biscuitbox/tilt_maze/stl/10_링크블록_x2.stl

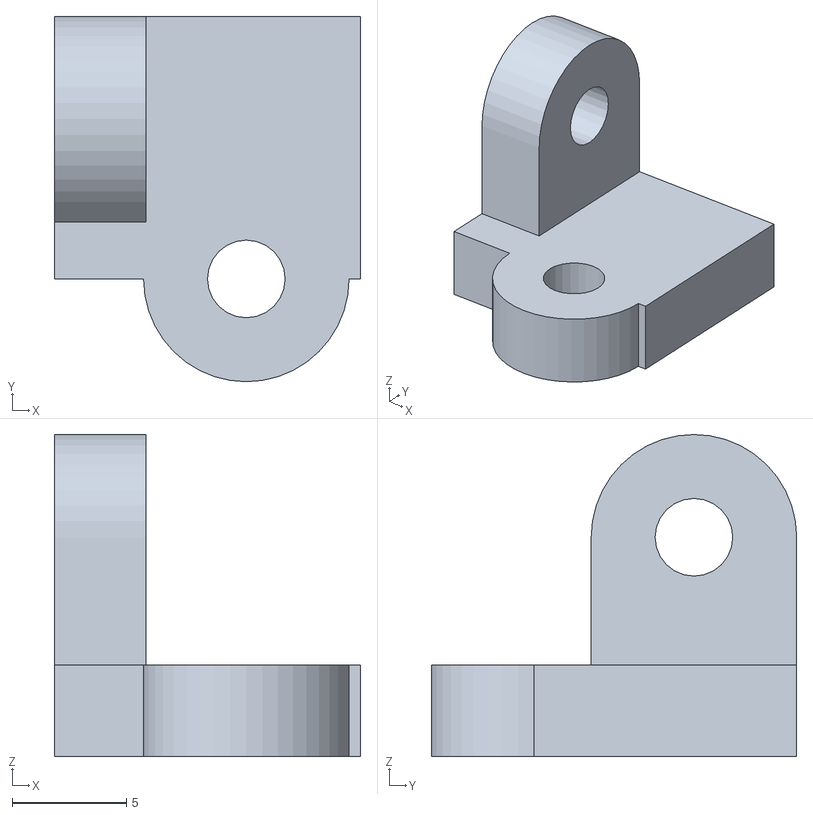
[picture p1: CAD file, 2026-10-22]
stl/10_링크블록_x2.stl
13.4 x 16.0 x 14.1
