biscuitbox/tilt_maze/stl/16a_QR안내판_글자QR(검은색).stl

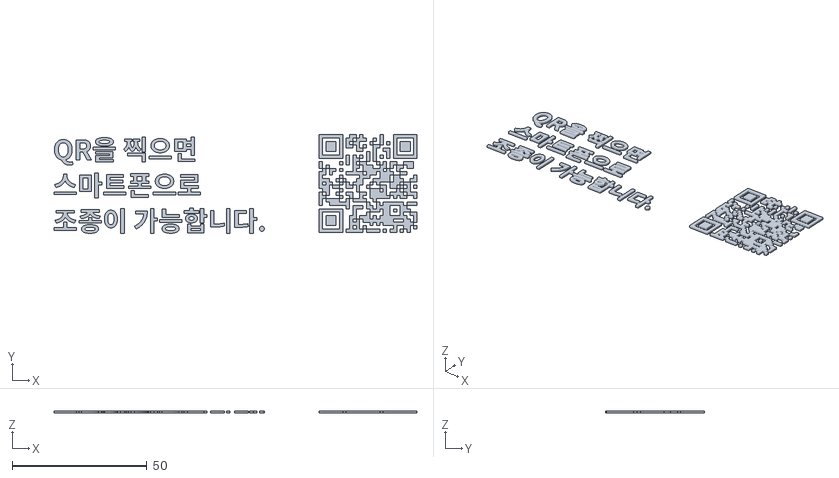
[picture p2: CAD file, 2026-10-22]
stl/16a_QR안내판_글자QR(검은색).stl
134.6 x 36.6 x 0.81
