biscuitbox/tilt_maze/stl/15a_ESP32홀더_38핀.stl

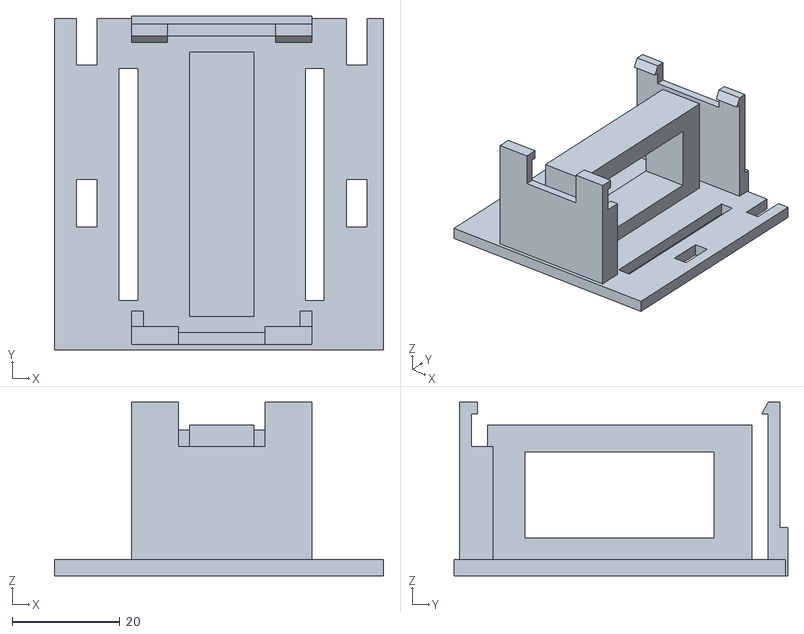
[picture p3: CAD file, 2026-10-22]
stl/15a_ESP32홀더_38핀.stl
61.0 x 61.9 x 32.2
