biscuitbox/tilt_maze/stl/13_배터리_뚜껑.stl

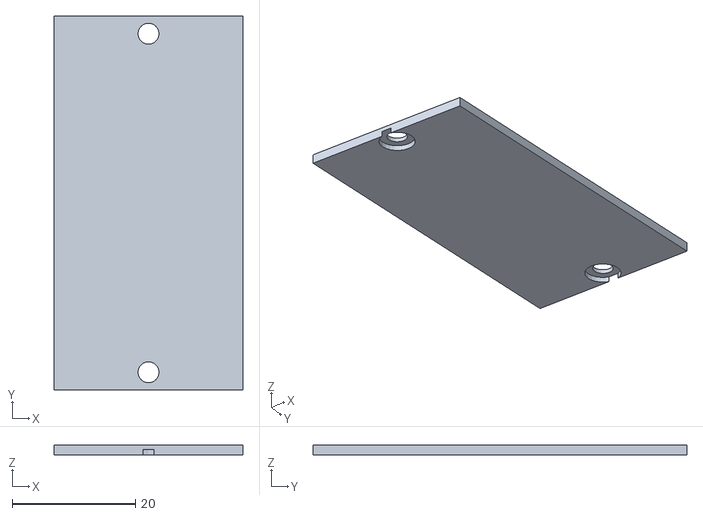
[picture p4: CAD file, 2026-10-22]
stl/13_배터리_뚜껑.stl
30.7 x 60.7 x 1.60
