biscuitbox/tilt_maze/stl/07_조종기_케이스.stl

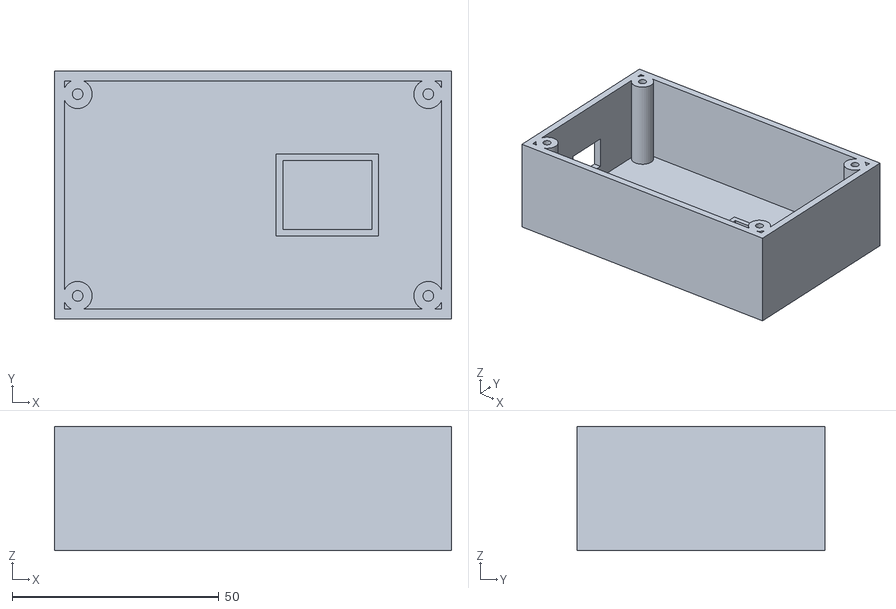
[picture p5: CAD file, 2026-10-22]
stl/07_조종기_케이스.stl
96.0 x 60.0 x 30.0
