biscuitbox/tilt_maze/stl/09a_링크_X_(긴것).stl

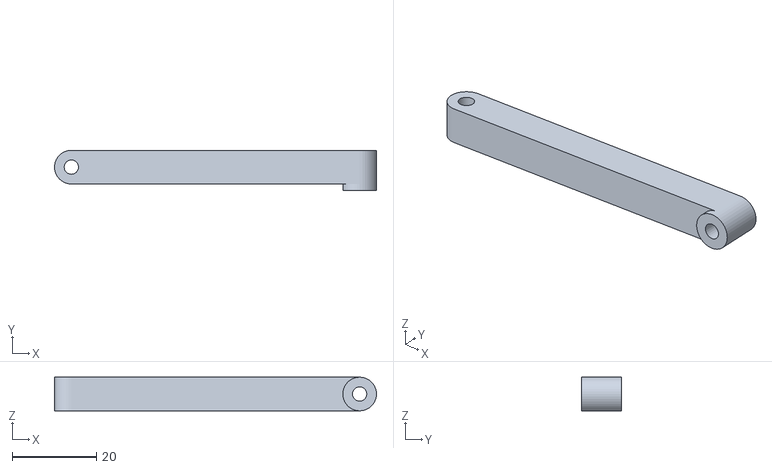
[picture p6: CAD file, 2026-10-22]
stl/09a_링크_X_(긴것).stl
76.5 x 9.60 x 8.00
