biscuitbox/tilt_maze/stl/16b_QR안내판_받침.stl

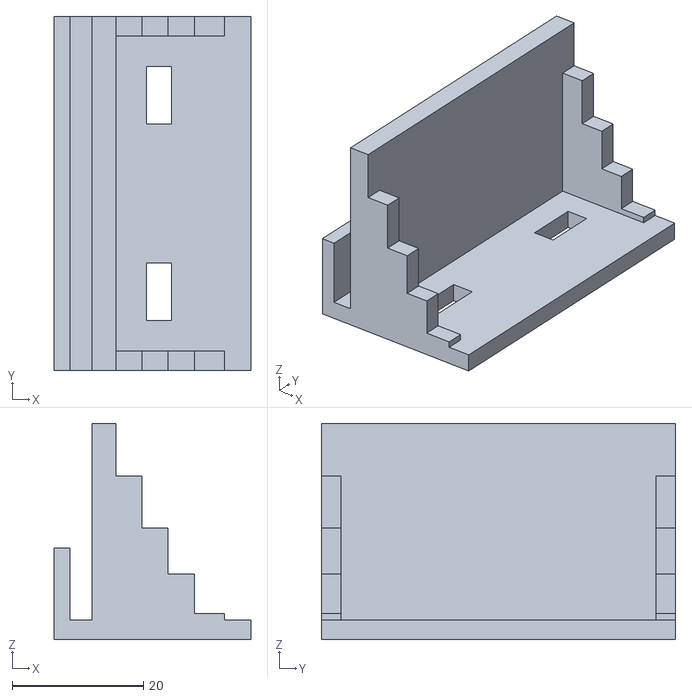
[picture p7: CAD file, 2026-10-22]
stl/16b_QR안내판_받침.stl
30.0 x 54.0 x 33.0
