biscuitbox/tilt_maze/stl/16a_QR안내판_두색.3mf

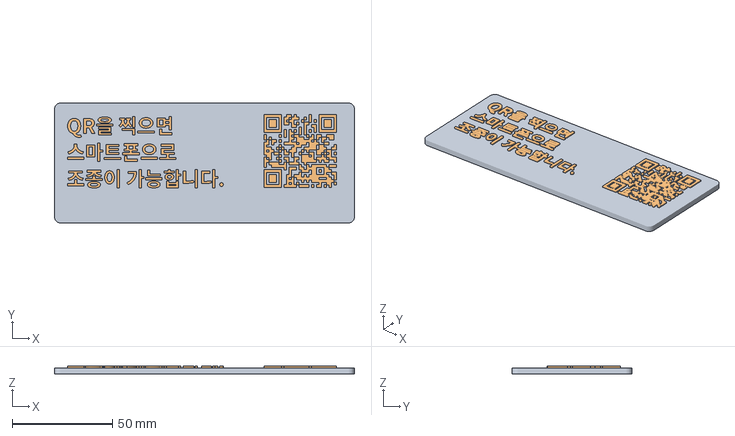
[picture p8: CAD file, 2026-10-22]
stl/16a_QR안내판_두색.3mf
150.0 x 60.0 x 3.80 mm
plate_white
marks_black
