biscuitbox/tilt_maze/stl/15b_ESP32홀더_30핀.stl

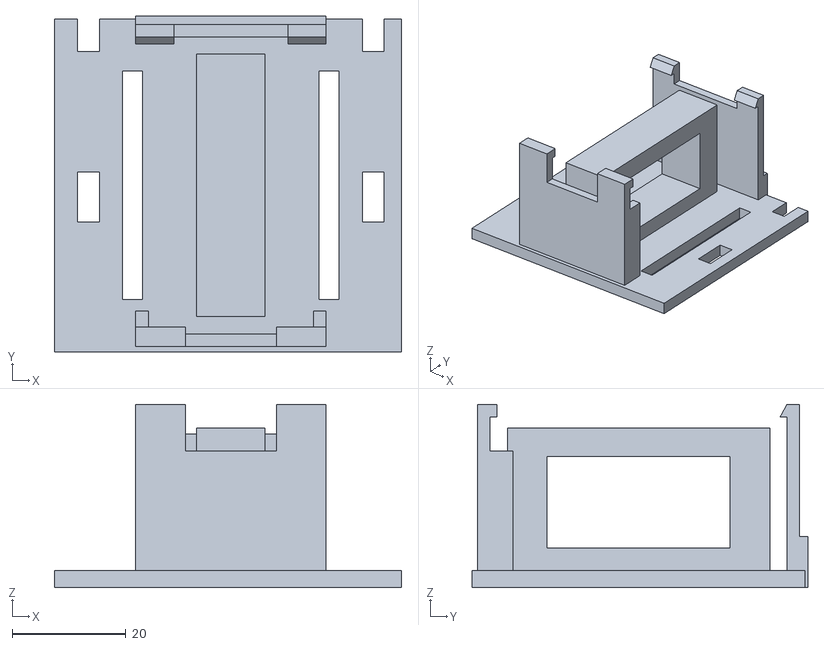
[picture p9: CAD file, 2026-10-22]
stl/15b_ESP32홀더_30핀.stl
61.0 x 59.0 x 32.2
