biscuitbox/tilt_maze/stl/02_하부프레임.stl

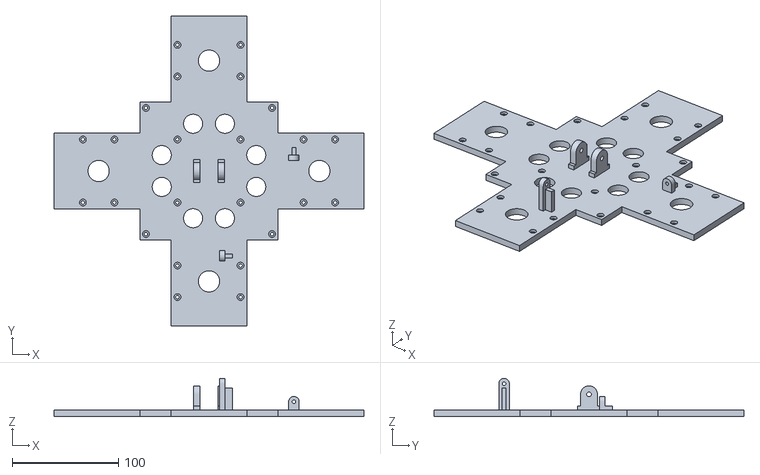
[picture p10: CAD file, 2026-10-22]
stl/02_하부프레임.stl
292.0 x 292.0 x 36.0
