biscuitbox/tilt_maze/stl/04_기둥_아래포크.stl

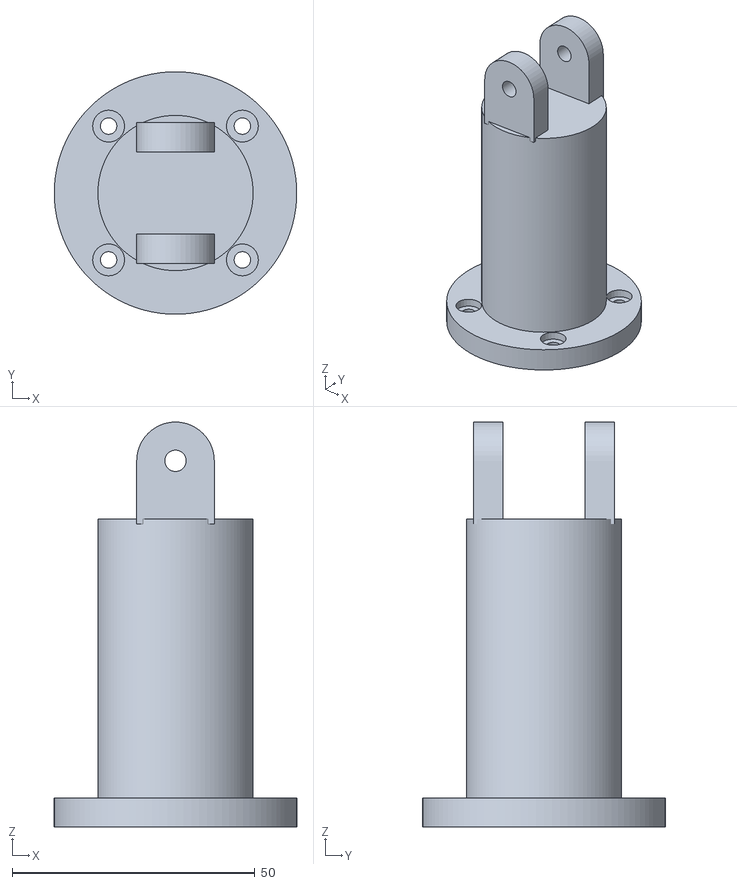
[picture p11: CAD file, 2026-10-22]
stl/04_기둥_아래포크.stl
50.0 x 50.0 x 83.5
