biscuitbox/tilt_maze/stl/01_미로판_300x300.stl

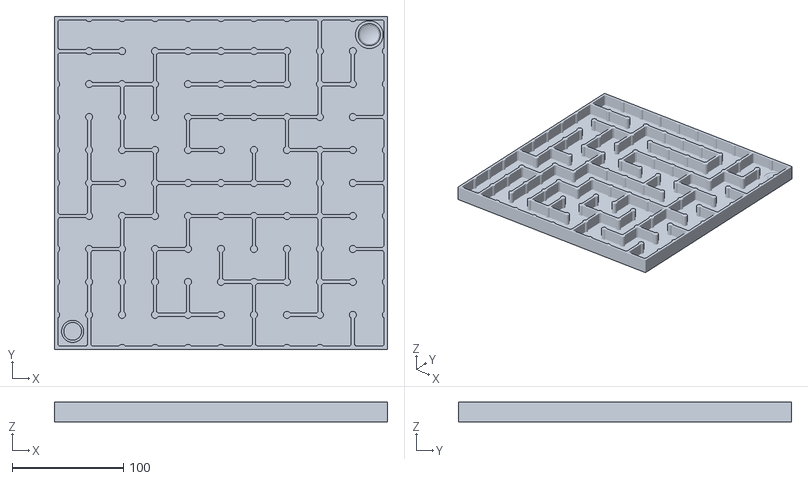
[picture p12: CAD file, 2026-10-22]
stl/01_미로판_300x300.stl
300.0 x 300.0 x 18.0
