biscuitbox/tilt_maze/stl/12_조종기_베젤.stl

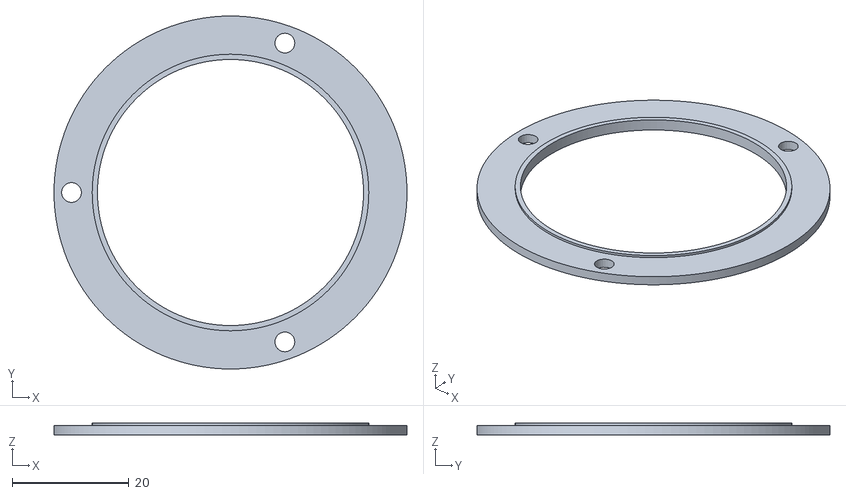
[picture p13: CAD file, 2026-10-22]
stl/12_조종기_베젤.stl
60.5 x 60.5 x 2.00
