biscuitbox/tilt_maze/stl/16a_QR안내판_판(흰색).stl

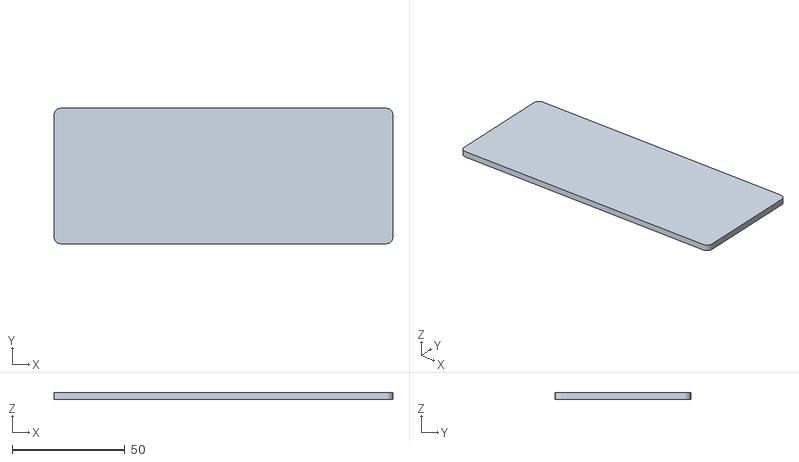
[picture p14: CAD file, 2026-10-22]
stl/16a_QR안내판_판(흰색).stl
150.0 x 60.0 x 3.00
