biscuitbox/tilt_maze/stl/09b_링크_Y_(짧은것).stl

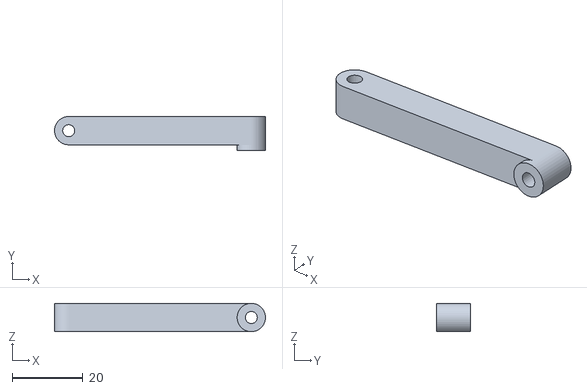
[picture p15: CAD file, 2026-10-22]
stl/09b_링크_Y_(짧은것).stl
59.5 x 9.60 x 8.00
