biscuitbox/tilt_maze/stl/16a_QR안내판.stl

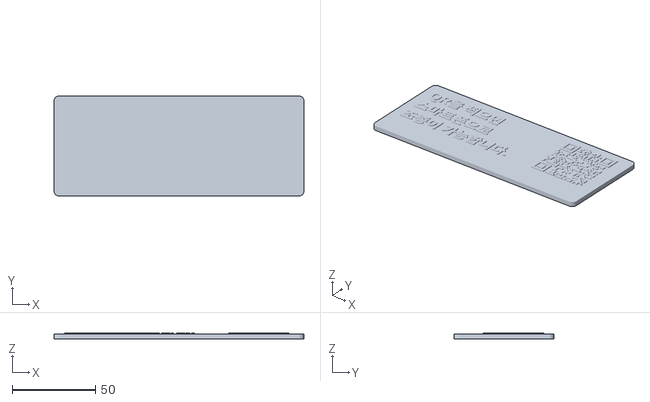
[picture p16: CAD file, 2026-10-22]
stl/16a_QR안내판.stl
150.0 x 60.0 x 3.80
