biscuitbox/tilt_maze/stl/08_조종기_뚜껑.stl

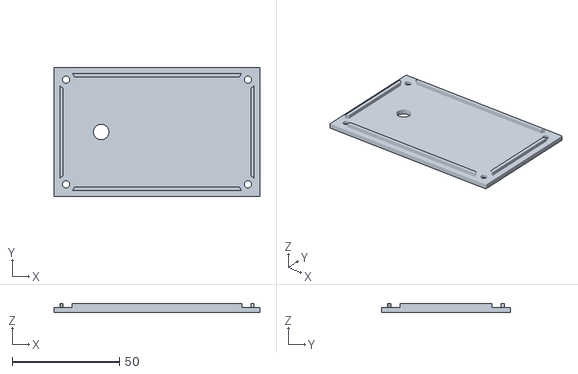
[picture p17: CAD file, 2026-10-22]
stl/08_조종기_뚜껑.stl
96.0 x 60.0 x 4.40
