biscuitbox/tilt_maze/stl/05_서보브래킷_x2.stl

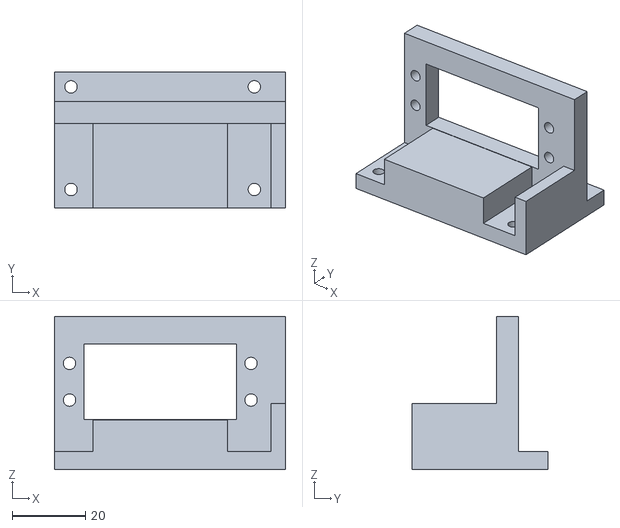
[picture p18: CAD file, 2026-10-22]
stl/05_서보브래킷_x2.stl
63.0 x 37.0 x 41.8
