biscuitbox/tilt_maze/stl/03_십자블록.stl

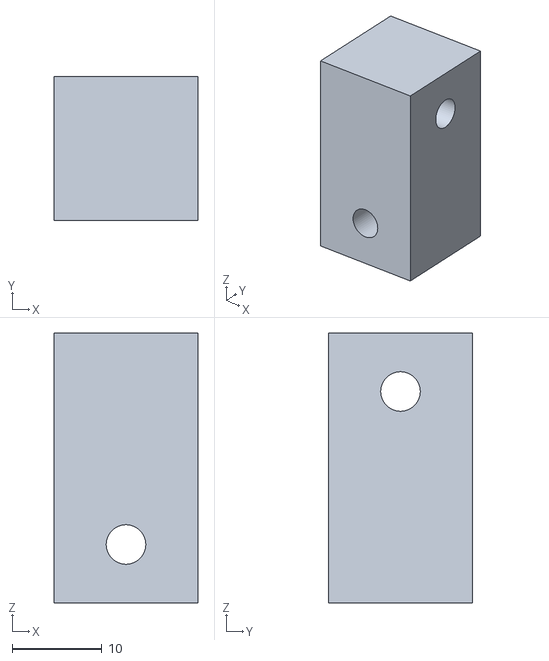
[picture p19: CAD file, 2026-10-22]
stl/03_십자블록.stl
16.0 x 16.0 x 30.0
