biscuitbox/tilt_maze/stl/11_조종기_손잡이.stl

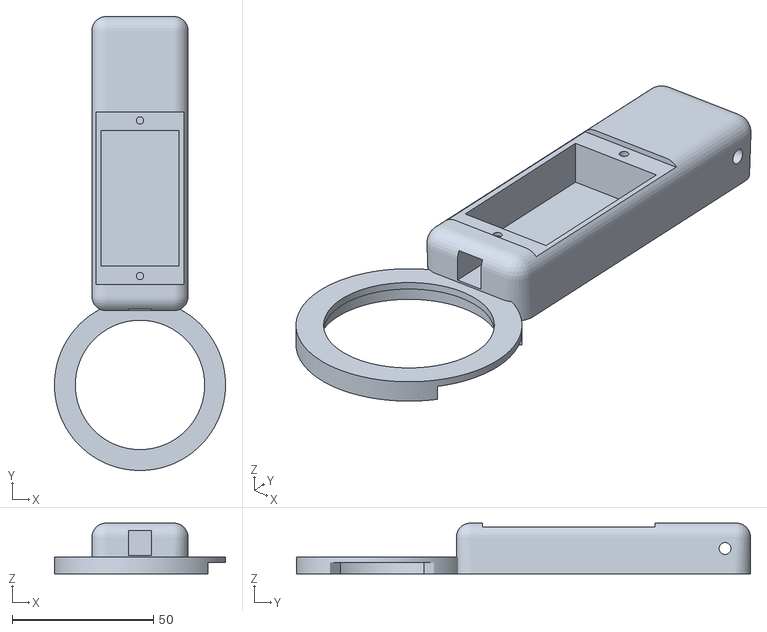
[picture p20: CAD file, 2026-10-22]
stl/11_조종기_손잡이.stl
60.5 x 160.5 x 18.0
