biscuitbox/tilt_maze/stl/14_맞춤확인링.stl

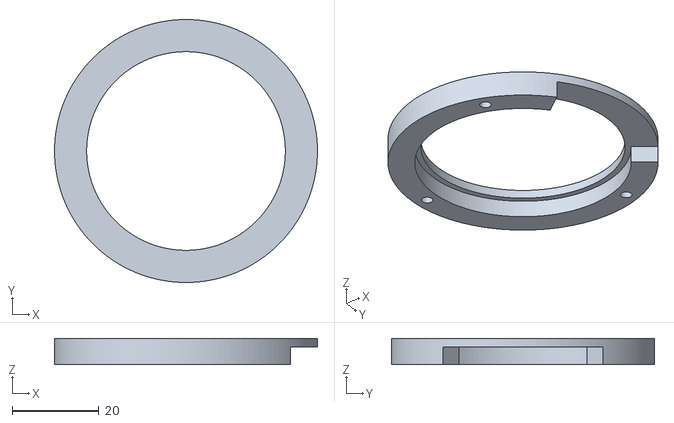
[picture p21: CAD file, 2026-10-22]
stl/14_맞춤확인링.stl
60.5 x 60.5 x 6.00
