biscuitbox/tilt_maze/stl/06_바닥판.stl

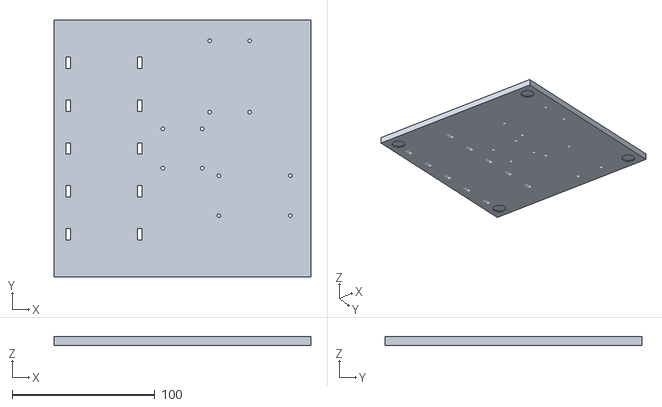
[picture p22: CAD file, 2026-10-22]
stl/06_바닥판.stl
180.0 x 180.0 x 6.00
