biscuitbox/tilt_maze/guide/index.html

ESP32 × 2 · MPU6050 · MG996R × 2 · ESP-NOW

# 원격 기울기 미로

손에 든 조종기를 기울이면, 떨어져 있는 300 mm 미로판이 같은 방향으로 기울어집니다. 구슬을 출발점에서 도착 홈까지 굴려 보내세요.

미로판 300 × 300 mm 칸 10 × 10 (간격 29.7 mm) 최단 경로 79칸 최대 기울기 ±8° 프린터 뱀부랩 H2S

## 내려받기

출력 파일 · 아두이노 코드 · 설계 원본

⬇ 전체 파일 한 번에 (zip) STL 출력 파일 (https://github.com/biscuitbox/tilt_maze/tree/main/stl) 아두이노 코드 (https://github.com/biscuitbox/tilt_maze/tree/main/code) 설계 원본 (Python) (https://github.com/biscuitbox/tilt_maze/tree/main/cad) 📱 스마트폰 조종 페이지

zip 안에 stl(출력 파일), code(미로·조종기 아두이노 코드), cad(치수를 바꿔 다시 만들 수 있는 파이썬 설계 원본)가 들어 있습니다. 아래 시뮬레이터로 먼저 움직임을 확인한 뒤 출력 목록과 조립 순서를 따라 만드세요.

## 시뮬레이터

구슬을 출발 고리에서 도착 홈까지

3D 모델 불러오는 중…

00:00.0

도착! 00:00.0

이니셜

기록 저장저장 안 함

미로판 정렬 처음부터 난이도 민감도 끝내기

드래그

처음부터 자동 시연 미로판 정렬 전체 화면

📱 이 폰 기울기로 조종 📱 폰을 조종기로 조종기 연결 (USB)

입력: 키보드·드래그

코드 ·····

준비 중…

폰 카메라로 QR을 찍어 열고 시작하기를 누르세요. 폰을 편하게 든 채로 미로판 정렬을 누르면 그 자세가 수평이 되고, 컴퓨터 화면이 기준 시점으로 돌아갑니다.

방향키·W·A·S·D·드래그·폰 모두 지금 보이는 화면 기준으로 움직입니다(위 = 화면 안쪽). 마우스로 화면을 끌면 시점이 돌아가고, 미로판 정렬을 누르면 출발점이 왼쪽 위에 오는 기준 시점으로 돌아옵니다. USB 조종기 연결은 내려받은 파일(tilt_maze_sim.html)을 크롬·엣지에서 열었을 때 동작합니다.

정답 경로 보기 조종기 표시 미로판만 보기

### 기록판

이 난이도 기록 지우기

도착하면 이니셜(3글자까지)로 기록을 남길 수 있습니다. 난이도마다 빠른 순서로 10개까지 보입니다. 검은 구멍에 빠지면 출발점에서 다시 시작하고 시간은 계속 흐릅니다. 자동 시연이나 정답 경로를 켠 판은 기록하지 않습니다.

미로판 하부프레임 기둥·십자블록 서보 브래킷 링크 링크블록 조종기

## 작동 원리

조종기 ESP32MPU6050으로 기울기를 읽고 자이로·가속도 상보 필터로 다듬음

ESP-NOW
50회/초 →

미로 ESP32손 기울기 × 0.35 → 미로판 목표 각도 (±8° 제한, 손떨림 ±1.5° 무시)

PWM →

서보 2개 + 프린팅 링크중심에서 80 mm 떨어진 두 지점을 밀어 올려 십자축 위의 판을 2축으로 기울임

미로판은 기둥 꼭대기의 십자축(유니버설 조인트) 위에 얹혀 있어 앞뒤·좌우로만 기울고 돌아가지 않습니다. 서보 혼 반경이 20 mm, 판 쪽 연결점이 80 mm라서 판 1°를 기울이려면 서보가 약 4.3° 돕니다. 판 ±8°는 서보 ±35° 정도라 MG996R의 범위 안에서 여유 있게 움직입니다.

서보와 판은 볼링크 대신 3D 프린팅 링크로 잇습니다. 링크 위쪽에는 작은 링크블록이 있어 볼트 두 개가 서로 직각으로 꽂히는데, 가운데 십자축과 같은 원리로 판이 어느 방향으로 기울어도 링크가 따라갑니다. 아래쪽은 서보 혼에 볼트 하나로 연결합니다. 링크 아랫핀이 비스듬해지는 각도는 판 ±8°에서 2° 남짓이라 볼트 구멍 여유로 충분히 흡수됩니다.

WiFi 공유기 없이 두 ESP32가 직접 통신합니다. 같은 교실에서 여러 세트를 돌릴 때는 세트마다 GROUP_ID를 다르게 주면 서로 섞이지 않습니다.

## 준비물

출력물 제외

전자 부품 | 수량
ESP32 DevKit (WROOM-32, 30/38핀 아무거나) | 2
MPU6050 모듈 (GY-521) | 1
MG996R 메탈기어 서보 (MG995·DS3218도 가능) | 2
5V 3A 이상 어댑터 + DC잭 단자 | 1
전해 커패시터 220~1000 µF, 10V 이상 | 1
7 mm 패널형 푸시버튼 (조종기 수평 저장) | 1
조종기 전원: 보조배터리 + USB 케이블 | 1
점퍼선, 미니 브레드보드 또는 만능기판 | —

기구 부품 | 수량
M3 × 20 볼트 (링크 ↔ 혼, 링크 ↔ 링크블록) | 4
M3 × 16 볼트 (링크블록 ↔ 프레임 탭) | 2
M3 나일론 너트 (링크 관절용) | 6
M4 × 35 볼트 + M4 나일론 너트 (십자축) | 2
M3 × 16 볼트 (미로판 ↔ 하부프레임) | 24
M3 × 16 볼트 + 너트 (서보 고정) | 8
M3 × 10 볼트 (기둥·브래킷 → 바닥판 4·8, 조종기 뚜껑 4) | 16
케이블타이 (폭 2.5 mm, 길이 150 mm 이상 — ESP32 홀더 2, QR 안내판 받침 1) | 3
고무발 Ø12 | 4
쇠구슬 또는 유리구슬 Ø16 | 1~2

볼링크·볼스터드 같은 RC 부품 없이 일반 M3·M4 볼트와 너트만 씁니다. 고정용 M3 볼트는 대부분 지름 2.6 mm 구멍에 직접 파고들게 설계해서 인서트 너트나 탭 작업도 필요 없습니다. 서보 혼만 회전 중심에서 20 mm 지점 구멍을 3.3 mm 드릴로 넓혀 주세요(3 mm 볼트가 살짝 기울어도 걸리지 않게).

## 출력 목록

뱀부랩 H2S (340 × 320 × 340) · PLA · 0.2 mm · 서포트 없음

파일 | 수량 | 크기 (mm) | 출력 메모
01_미로판_300x300 | 1 | 300×300×18 | 통짜 한 장, 베드 가운데. 벽(외곽선) 4줄, 채움 15%. 아래에서 나사가 기둥으로 파고들어서 외곽선이 중요합니다.
02_하부프레임 | 1 | 292×292×36 | 허브와 팔 4개 일체. 파일 그대로(윗면이 베드, 포크·탭이 위). 채움 30%
03_십자블록 | 1 | 16×16×30 | 채움 100% 권장
04_기둥_아래포크 | 1 | 50×50×84 | 채움 30%
05_서보브래킷 | 2 | 63×37×42 | 서보 창 윗변은 브리지 41 mm. 채움 30%
06_바닥판 | 1 | 180×180×6 | 채움 20%
07_조종기_케이스 | 1 | 96×60×30 | 바닥의 화살표 = 조종기 앞쪽
08_조종기_뚜껑 | 1 | 96×60×4 | 버튼 구멍 Ø7.2
09a_링크_X (긴 것) | 1 | 77×10×8 | 옆으로 누운 상태. 벽 4줄, 채움 100%
09b_링크_Y (짧은 것) | 1 | 60×10×8 | 옆으로 누운 상태. 벽 4줄, 채움 100%
10_링크블록 | 2 | 13×16×14 | 채움 100%
15a_ESP32홀더_38핀 15b_ESP32홀더_30핀 | 1 | 61×62×32 | 미로 쪽 ESP32 받침. 내 보드 길이에 맞는 것 하나만 (38핀 약 54 mm, 30핀 약 51.5 mm). 파일 그대로, 채움 20%
16a_QR안내판 | 1 | 150×60×3.8 | 폰 조종 주소 QR + 안내 문장. 판은 흰색, 글자·QR(위 0.8 mm)은 검은색. AMS가 있으면 16a_QR안내판_두색.3mf, 없으면 높이 3.0 mm에서 필라멘트 교체
16b_QR안내판_받침 | 1 | 30×54×33 | 파일 그대로, 채움 20%

H2S의 출력 크기(340 × 320 mm)에 맞춰 미로판과 하부프레임을 각각 한 장으로 출력합니다. 미로판은 앞뒤(Y) 여유가 10 mm씩이니 베드 가운데에 놓으세요. 출발 고리는 왼쪽 아래(−X, −Y) 모서리, 도착 홈은 오른쪽 위 모서리에 있습니다. 작은 부품(03~10)은 한 판에 모아 같이 출력해도 됩니다.

## 배선

### 조종기 tilt_controller

MPU6050 / 버튼 | ESP32
VCC | 3V3
GND | GND
SDA | GPIO 21
SCL | GPIO 22
버튼 한쪽 / 다른 쪽 | GPIO 4 / GND

GY-521 보드의 X 화살표가 조종기 앞(미로 쪽)을 향하고 칩이 위를 보게, 케이스 바닥의 사각 틀 안에 양면테이프로 붙입니다.

### 미로 본체 tilt_maze_receiver

연결 | 대상
서보 X 신호 (주황) | GPIO 18
서보 Y 신호 (주황) | GPIO 19
서보 빨강 ×2 | 5V 어댑터 +
서보 갈색 ×2 | 5V 어댑터 −
ESP32 5V(VIN) / GND | 5V 어댑터 + / −
220~1000 µF (+다리 → +) | 5V 어댑터 +/− 사이

서보 전원을 ESP32의 5V 핀이나 USB에서 끌어오지 마세요. 두 서보가 동시에 움직이면 순간 전류가 1 A를 넘어 ESP32가 재부팅(브라운아웃)됩니다. 어댑터에서 서보와 ESP32로 따로 나누고, GND는 반드시 하나로 묶습니다.

## 전체 배선도

미로 본체 · 조종기 2종 · 무선 연결

미로 본체. 서보 전원은 어댑터에서 직접 받고, ESP32의 5V 핀에서 끌어오지 않습니다. 모든 GND(어댑터 −, ESP32, 서보 갈색선, 커패시터 −)를 한 줄로 묶어야 서보가 신호를 제대로 읽습니다. 서보 Y 신호선이 서보 X 갈색선을 넘는 곳(반원 표시)은 연결되지 않은 교차입니다.

조종기는 둘 중 하나만 있으면 됩니다. 조종기 A의 버튼은 GPIO 4와 GND 사이에 연결합니다(내부 풀업 사용, 저항 불필요).

무선 연결 전체. 스마트폰과 무선 조종기를 둘 다 켜 두면 마지막으로 신호를 보낸 쪽을 따릅니다. 점선은 무선, 실선은 전선입니다.

## 조립 순서

1. 기둥을 바닥판 가운데에 고정M3×10 4개. 기둥 위 포크의 볼트 구멍이 Y 방향(앞뒤)을 향하게 놓습니다. 미리보기에서 서보 두 개가 있는 쪽이 +X(오른쪽), 위쪽이 +Y입니다.
2. 서보를 브래킷에 끼우고 바닥판에 고정서보를 브래킷 앞쪽(혼 쪽)에서 창으로 밀어 넣고 귀를 M3×16 + 너트로 고정합니다. 서보 X는 오른쪽 앞(+X, −Y) 자리, 서보 Y는 같은 부품을 90° 돌려 오른쪽 뒤(+X, +Y) 자리에 M3×10으로 고정합니다. 서보 축은 중심에서 60 mm 떨어진 X축·Y축 위에 옵니다.
3. ESP32 홀더 고정홀더를 바닥판 왼쪽 앞(−X, −Y) 자리에 USB 쪽(가운데가 크게 파인 벽)이 앞 가장자리를 향하게 놓습니다. 발판의 구멍 4개가 바닥판의 케이블타이 구멍과 겹칩니다. 케이블타이를 바닥판 아래에서 한 구멍으로 올려 발판 위를 지나 다른 구멍으로 내려 묶습니다(2개). ESP32는 핀에 점퍼선을 먼저 꽂은 뒤, USB 쪽 끝을 턱 아래로 밀어 넣고 반대쪽 끝을 눌러 딸깍 끼웁니다. 빼낼 때는 안테나 쪽 벽을 살짝 바깥으로 젖힙니다. 받침 위 28 mm 높이라 아래로 난 핀에 점퍼선을 꽂을 공간이 있고, 판을 ±10° 기울여도 움직이는 부품과 닿지 않습니다.

바닥판 왼쪽 앞에 놓인 주황색 ESP32 홀더. 가운데 받침 위에 ESP32가 올라가 있고, 아래로 난 핀에 점퍼선이 꽂혀 옆으로 빠지며, 케이블타이가 발판을 바닥판에 묶고 있다

  ESP32 홀더 자리. USB 단자가 바닥판 앞 가장자리를 향해서 미로판을 들지 않고도 코드를 올릴 수 있습니다.
4. QR 안내판 달기받침을 바닥판 왼쪽 가장자리(−X) 가운데보다 뒤쪽에 놓아 발판 구멍 2개를 바닥판의 케이블타이 구멍과 맞추고 케이블타이 1개로 묶습니다. 안내판을 글자가 바깥을 보게 해서 받침 홈에 위에서 끼우면, 미로 옆에서 폰 카메라로 바로 찍을 수 있습니다. QR은 https://biscuitbox.github.io/tilt_maze/로 연결되며, 판을 ±10° 기울여도 안내판 위로 14 mm 이상 여유가 있습니다.

미로 받침 왼쪽 가장자리에 세운 흰 안내판. 'QR을 찍으면 스마트폰으로 조종이 가능합니다.' 문장 오른쪽에 검은 QR코드가 있고, 아래 주황색 받침 홈에 끼워져 있다

  미로 옆(−X 쪽)에서 본 QR 안내판. 오른쪽 주황색 부품은 ESP32 홀더입니다.
5. 미로판 조립미로판을 뒤집어 놓고 하부프레임을 얹어 M3×16 24개로 조입니다. 프레임의 짧은 탭 팔이 +X(도착 홈 쪽 오른편), 긴 탭 팔이 +Y(먼 쪽)를 향해야 합니다. 출발 고리가 있는 모서리 쪽 두 팔에는 탭이 없습니다.
6. 십자블록 연결십자블록을 프레임 가운데 포크 사이에 넣고 M4×35로 끼운 뒤(위 축), 판째 들어 기둥 포크에 끼우고 두 번째 M4×35를 넣습니다(아래 축). 나일론 너트는 덜컹거림이 없을 만큼만 조여서 판이 손가락으로 부드럽게 기울어야 합니다.
7. 코드 업로드 후 서보 혼 장착혼을 끼우기 전에 미로 쪽 코드를 올리고 전원을 켜면 서보가 90°로 섭니다. 이 상태에서 혼을 수평, 바깥쪽(판 가장자리 방향)으로 끼웁니다. 혼의 회전 중심에서 20 mm 지점 구멍은 미리 3.3 mm 드릴로 넓혀 둡니다.
8. 링크 연결 (아래 링크 연결 그림 참고) ① 링크블록을 프레임 탭 안쪽에 대고 M3×16으로 끼웁니다. 볼트 머리는 링크 쪽, 나일론 너트는 탭 바깥쪽입니다. ② 링크 윗구멍을 링크블록 아래 귀에 M3×20으로 연결합니다. ③ 링크 아랫구멍을 혼 바깥면에 대고 M3×20으로 연결합니다. 긴 링크 X는 서보 X, 짧은 링크 Y는 서보 Y에 답니다. 나일론 너트는 덜컹거림이 없어질 만큼만 조여 관절이 손으로 부드럽게 돌아가야 합니다. 링크 길이는 고정이라 판 수평은 다음 단계의 서보 중앙값으로 맞춥니다(1°당 약 0.35 mm).
9. 조종기 조립ESP32와 MPU6050, 버튼을 배선하고 케이스에 넣습니다. USB 케이블은 뒤쪽 구멍으로 빼서 보조배터리에 연결합니다. 뚜껑은 M3×10 4개.

## 링크 연결 그림

서보 X 쪽 · 서보 Y 쪽도 같은 방법

링크 하나에 볼트 3개가 들어갑니다. 순서대로 ① 탭과 링크블록, ② 링크블록과 링크 윗구멍, ③ 링크 아랫구멍과 서보 혼을 연결합니다. 나일론 너트는 모두 덜컹거림이 없어질 만큼만 조여서 관절이 손으로 부드럽게 돌아가야 합니다. 그림은 실제 출력 형상 그대로이며, 분해도는 부품을 볼트 방향으로 떼어 놓은 모습입니다.

링크 연결 전체: 하부프레임 탭, 링크블록, 긴 링크 X, 서보 X 혼이 볼트 3개로 이어진 모습

전체 모습. 번호는 볼트 위치입니다.

① 탭과 링크블록 분해도: M3×16 볼트는 링크블록 쪽에서 넣고 나일론 너트는 탭 바깥쪽

① 링크블록의 넓은 판을 탭 안쪽(링크가 올 쪽) 면에 대고 M3×16을 링크블록 쪽에서 넣습니다. 너트는 탭 바깥쪽, 보강 리브 아래 빈 곳에 들어갑니다.

② 링크블록 귀와 링크 윗구멍 분해도: M3×20 볼트를 귀 바깥에서 넣고 너트는 링크 너머

② 링크 윗구멍을 링크블록 아래 귀 옆에 맞추고, M3×20을 귀 바깥쪽에서 넣어 링크 너머에서 너트로 잡습니다.

③ 링크 아랫구멍과 서보 혼 분해도: M3×20 볼트를 링크 쪽에서 넣고 너트는 혼 뒤쪽

③ 링크 아랫구멍의 튀어나온 면을 혼 바깥면에 대고 M3×20을 링크 쪽에서 넣습니다. 너트는 혼 뒤쪽입니다. 혼 구멍은 3.3 mm로 넓혀 두세요.

위치 | 볼트 | 머리 방향 | 너트 위치
① 탭 ↔ 링크블록 | M3×16 | 링크블록 쪽 | 탭 바깥
② 링크블록 ↔ 링크 위 | M3×20 | 귀 바깥 | 링크 너머
③ 링크 아래 ↔ 서보 혼 | M3×20 | 링크 쪽 | 혼 뒤

서보 Y 쪽은 짧은 링크 Y(09b)와 긴 탭이 있는 팔을 쓰고, 모든 것을 90° 돌린 같은 배치입니다. 링크블록은 X·Y 공용입니다.

## 처음 켜고 맞추기

두 코드 모두 추가 라이브러리가 필요 없습니다. 보드는 ESP32 Dev Module, ESP32 Arduino 코어 3.x(3.3.0에서 컴파일 확인)와 2.x 둘 다 지원합니다.

1. 미로 쪽 수평 맞추기시리얼 모니터(115200)를 열고 h로 수평 고정 모드를 켭니다. 판이 기울어 있으면 q/a(서보 X), w/s(서보 Y)로 0.5°씩 맞춥니다. 값은 자동 저장됩니다.
2. 서보 방향 확인t를 누르면 판이 +X쪽 → −X쪽 → +Y쪽 → −Y쪽 순서로 내려갑니다. 순서와 반대로 움직이는 축이 있으면 x 또는 y로 뒤집습니다. 확인이 끝나면 h로 고정 모드를 끕니다.
3. 조종기 수평 저장조종기를 켜고 2초 동안 가만히 둡니다(자이로 보정, LED 깜빡임). 편하게 잡은 자세에서 버튼을 짧게 누르면 그 자세가 0°로 저장됩니다.
4. 조작 방향 확인미로판의 −Y쪽(출발 고리 쪽)에 서서 조종기를 오른쪽으로 기울이면 판 오른쪽이, 앞으로 기울이면 판 먼 쪽이 내려가야 합니다. 반대면 미로 코드의 MAP_RIGHT_DIR, MAP_FRONT_DIR를 −1로 바꿉니다.

### 떨림 없이 부드럽게 움직이는 원리

미로 쪽 코드는 조종기 값을 서보로 바로 보내지 않고 네 단계를 거칩니다. 손을 급하게 꺾거나 마구 흔들어도 미로판은 정해진 최대 속도·가속도 안에서 S자 곡선으로 움직입니다.

단계 | 하는 일
① 튀는 값 거르기 | 무선 잡음으로 20 ms 사이에 40° 넘게 튄 값은 버립니다
② 적응형 필터 (One Euro) | 손이 느릴 때는 강하게 걸러 손떨림·센서잡음을 없애고, 빠를 때는 약하게 걸러 늦지 않게 합니다
③ PID 추종 제어 | 미로판 각도를 계산 속의 판으로 따라가게 합니다. 목표와의 차이(P)와 판의 속도(D)로 가속도를 정하고, 최대 속도 80°/s·최대 가속도 700°/s²를 넘지 않게 제한합니다
④ 정지 구간 출력 고정 | 판이 0.3초 이상 멈춰 있으면 0.15° 미만의 변화는 서보에 보내지 않습니다. 서보가 불감대 근처의 미세한 명령에 덜덜 떠는 것(헌팅)을 막습니다

PID의 I(적분)는 기본 0입니다. 이 구조에는 미로판의 실제 각도를 재는 센서가 없어서 적분할 오차가 없기 때문입니다. 시리얼 모니터에서 g를 누르고 아두이노 IDE의 시리얼 플로터를 열면 원래값·필터값·판 명령을 그래프로 비교할 수 있습니다.

### 조작감 조절 (tilt_maze_receiver.ino 위쪽)

값 | 기본 | 바꾸면
HAND_GAIN | 0.35 | 클수록 손을 조금만 기울여도 판이 많이 기울어집니다
MAX_TILT | 8.0° | 구슬이 너무 빠르면 5~6°로. 10°를 넘기지 마세요
DEADZONE | 1.5° | 손떨림으로 판이 계속 꿈틀대면 크게
PID_KP / PID_KD | 150 / 24.5 | KP가 클수록 빠릿하게 따라갑니다. KD는 2×√KP로 맞추면 넘치지 않고 딱 멈춥니다
MAX_SPEED | 80°/s | 판이 움직이는 최고 속도. 서보가 버거워하면 60으로
MAX_ACCEL | 700°/s² | 작을수록 출발·정지가 부드럽습니다
FILTER_MIN_CUTOFF | 2.0 Hz | 가만히 들고 있을 때 판이 꿈틀대면 1.0~1.5로 낮춤
HOLD_BAND | 0.15° | 멈춘 상태에서 서보가 떨리면 0.2~0.3으로
HORN_R | 20 mm | 링크를 혼의 다른 구멍에 달았다면 실제 거리로

## 조종기로 PC 시뮬레이터 움직이기

맨 위 시뮬레이터를 진짜 조종기로 조종할 수 있습니다. 브라우저 보안 때문에 이 페이지 안에서는 USB를 쓸 수 없고, 함께 받은 tilt_maze_sim.html 파일을 컴퓨터의 크롬이나 엣지에서 열어야 합니다(인터넷 연결 필요). 조종기 연결 (USB)을 누르고 포트를 고르면 됩니다.

PC에 꽂는 것 | 화면에 나오는 것
조종기 (MPU6050 또는 원형 화면) — USB 케이블 | 조종기 기울기로 화면 속 미로판이 움직임. 미로 쪽과 같은 필터·PID 계산을 화면이 대신 함
미로 본체 ESP32 — USB 케이블, 조종기는 무선 | 실제 미로판 각도를 그대로 따라 움직임. 실제 미로와 화면을 나란히 비교할 수 있음
남는 ESP32 하나에 미로 쪽 코드만 올려서 — USB 케이블 | 서보 없이 무선 조종기 → PC 중계기. 미로를 만들기 전에도 조종기로 화면 미로를 즐길 수 있음

보드는 PC가 보내는 W 문자를 받으면 TILT,… 줄을 1초에 50번 보냅니다. 연결하기 전에 아두이노 IDE의 시리얼 모니터는 닫아 두세요(포트를 한 프로그램만 쓸 수 있습니다).

## 스마트폰으로 조종하기

웹앱 tilt_phone.html · 블루투스

스마트폰의 기울기 센서로 미로를 조종합니다. 웹앱이 블루투스(BLE)로 미로 ESP32에 바로 연결되므로 와이파이나 인터넷 서버가 필요 없습니다. 미로 쪽 코드의 USE_BLE가 1이면 무선 조종기와 함께 쓸 수 있고, 마지막으로 신호를 보낸 쪽을 따릅니다.

1. 미로 쪽 코드 다시 올리기아두이노 IDE의 도구 → Partition Scheme을 Huge APP (3MB No OTA)로 바꾼 뒤 tilt_maze_receiver.ino를 올립니다. 시리얼 모니터에 블루투스 이름: TiltMaze-1이 나오면 준비된 것입니다. 숫자는 GROUP_ID라서 세트마다 다르게 하면 폰에서 구분됩니다.
2. 웹앱을 https 주소에 올리기브라우저는 https 주소에서만 기울기 센서와 블루투스를 쓰게 해 줍니다. tilt_phone.html을 index.html로 이름을 바꿔 GitHub 저장소에 올리고 Settings → Pages에서 켜면 됩니다. 이 안내 페이지 안에서는 브라우저가 센서와 블루투스를 막아서 동작하지 않습니다.
3. 폰에서 열기안드로이드는 크롬으로 주소를 엽니다. 아이폰 사파리는 웹 블루투스를 지원하지 않아서 앱스토어의 Bluefy 브라우저로 열어야 하고, 처음에 기울기 센서 켜기를 눌러 허락합니다.
4. 연결하고 조종미로 연결을 누르고 목록에서 TiltMaze-1을 고릅니다. 폰을 세로로, 화면 위쪽이 미로를 향하게 들고 편한 자세에서 지금 자세를 수평으로를 누릅니다. 화면의 은색 구슬은 내 기울기, 초록 고리는 실제 미로판 각도입니다.

웹앱 기능 | 설명
민감도 | 0.5~1.6배. 어린 학생은 0.7 정도로 낮추면 조종이 쉬워집니다
서 있는 곳 | 기본은 QR 안내판 쪽(미로 왼쪽). 내가 선 쪽을 고르면 폰을 앞으로 숙일 때 늘 내 앞쪽(먼 쪽) 미로판이 내려갑니다
시작·도착 기록 | ▶ 시작을 누르면 3·2·1 뒤 시간이 흐르고, 구슬이 도착 홈에 들어가면 🏁 도착!을 누릅니다. 별명(10글자까지)을 적어 저장하면 사이트 순위(20위까지)에 올라가고 내 순위가 바로 나옵니다
일시정지 | 누르면 미로판이 수평으로 돌아갑니다. 폰을 내려놓을 때 사용
화면 꺼짐 방지 | 연결된 동안 화면이 꺼지지 않습니다
센서 없는 기기 | 원판을 손가락이나 마우스로 끌어서 조종할 수 있습니다

### 실물 없이 시뮬레이터를 폰으로 조종하기

미로를 만들기 전이나 기록 대결을 할 때는 위 시뮬레이터를 폰 기울기로 움직일 수 있습니다. 두 방법 모두 이 페이지를 https 웹 주소(예: 깃허브 페이지)에 올렸을 때 동작합니다.

방법 | 쓰는 법
이 폰 기울기로 조종 | 폰에서 이 페이지를 열고 시뮬레이터 아래 📱 이 폰 기울기로 조종을 누릅니다. 시뮬레이터가 화면을 꽉 채우고, 아래 막대에서 정렬·처음부터·난이도·민감도를 바꿉니다. 기울이다가 화면이 돌아가지 않게 폰의 화면 회전 잠금을 켜 두세요.
폰을 조종기로 컴퓨터·교실 TV 화면 + 폰 | 컴퓨터에서 📱 폰을 조종기로를 누르면 QR코드와 5글자 코드가 나옵니다. 폰 카메라로 QR을 찍어 열고 시작하기를 누르면 연결됩니다. 연결에는 인터넷이 필요하고(PeerJS 무료 중계 서버로 처음 연결만 맺음), 학교 와이파이가 막으면 폰과 컴퓨터를 같은 와이파이에 연결해 보세요.
미로판 정렬 | 폰을 편하게 든 채로 누르면 그 자세가 수평이 되고, 화면이 출발점이 왼쪽 위·도착이 오른쪽 아래인 기준 시점으로 돌아갑니다. 폰 위쪽을 숙이면 구슬이 화면 위쪽(안쪽)으로, 오른쪽을 내리면 오른쪽으로 굴러갑니다. 시점을 돌려도 방향은 늘 지금 화면 기준입니다.

블루투스를 켜면 미로 ESP32가 와이파이(ESP-NOW)와 블루투스를 번갈아 쓰기 때문에, 무선 조종기의 반응이 조금 느려질 수 있습니다. 스마트폰을 쓰지 않을 때는 USE_BLE를 0으로 바꿔 올리면 원래 속도로 돌아갑니다.

## 원형 화면 조종기

ESP32-S3-Touch-AMOLED-1.75 · 선택

MPU6050 조종기 대신 웨이브쉐어 1.75인치 원형 AMOLED 보드를 쓸 수 있습니다. 보드 안의 6축 센서(QMI8658)로 기울기를 재고, 화면에 미로판이 기울어질 방향을 구슬로 보여 줍니다. 미로 쪽 코드는 그대로입니다.

준비물 | 수량
ESP32-S3-Touch-AMOLED-1.75 (기판만 있는 기본형) | 1
3.7V 리튬폴리머, MX1.25 2핀 (최대 45×27×11 mm, 예: 802540) | 1
M3 × 6 볼트 (베젤) / M3 × 8 볼트 (배터리 뚜껑) | 3 / 2

출력물 | 메모
14_맞춤확인링 | 먼저 뽑아 보드를 끼워 보기 (5분)
11_조종기_손잡이 | 윗면이 베드. 서포트 없음
12_조종기_베젤 | 앞면이 베드
13_배터리_뚜껑 | 그대로

제조사가 보드 치수를 글로 공개하지 않아 케이스는 지름 48.0 mm, 두께(기판 뒷면~유리 윗면) 3.8 mm로 추정해 만들었습니다. 캘리퍼스로 재서 controller_amoled_case.py 맨 위의 BOARD_D, STACK_FRONT를 고치고 다시 실행한 뒤, 맞춤확인링으로 먼저 확인하세요.

1. 배터리 넣기배터리를 손잡이 칸에 넣고 선을 앞쪽 통로로 빼서 보드 뒷면 MX1.25 커넥터에 꽂습니다. 커넥터 극성은 제조사마다 반대인 경우가 있으니 보드의 +/− 표시와 빨간 선이 맞는지 꼭 확인하세요.
2. 보드 끼우기보드의 USB-C·버튼이 오른쪽 창으로 오게 돌려서 턱 위에 올리고, 베젤을 M3×6 3개로 덮습니다. 보드가 덜컹거리면 턱 위에 얇은 양면 폼테이프를 붙입니다.
3. 코드 올리기tilt_controller_amoled.ino. 보드 ESP32S3 Dev Module, Flash 16MB, PSRAM은 OPI PSRAM, Partition은 3MB APP, USB CDC On Boot는 Enabled로 설정합니다. 라이브러리는 웨이브쉐어 예제의 GFX Library for Arduino 1.6.4, SensorLib 0.3.1, XPowersLib 0.2.6과 라이브러리 매니저의 U8g2를 씁니다.
4. 방향 맞추기처음 켜면 자동으로 시작합니다. 손잡이를 내 쪽으로 하고 수평으로 들고 기다린 뒤, 미로 쪽으로 숙이고, 화면 화살표가 미로 쪽을 가리킬 때까지 BOOT를 짧게 눌러 돌린 뒤 길게 눌러 저장합니다. 보드를 다시 끼웠을 때는 BOOT를 4초 눌러 다시 합니다.

BOOT 버튼 | 동작
짧게 | 타이머 시작 → 멈춤 → 0으로
1초 이상 | 지금 자세를 수평으로 저장 (화면 가장자리 주황 고리가 다 차면 손을 뗌)
4초 이상 | 방향 맞추기 (초록 고리)

## 문제가 생기면

서보가 움직일 때 ESP32가 재부팅되거나 서보가 떨린다

떨림의 가장 흔한 원인은 코드보다 전원입니다. 어댑터 용량(3 A 이상), 서보 바로 옆의 1000 µF 커패시터, GND 공통 연결을 확인하고 서보 전원선은 굵고 짧게 합니다. 서보 커넥터를 뺀 채로 판을 손으로 움직여 덜컹거림이 있으면 링크 관절 너트를 조금 조입니다.

전원을 바꿔도 멈춰 있을 때 서보가 계속 '지잉' 떤다

MG996R 호환품 중에는 불감대가 불안정한 것이 많습니다. HOLD_BAND를 0.25로 올려 보고, 그래도 떨리면 같은 크기의 디지털 서보(DS3218 등)로 바꾸는 것이 확실합니다.

미로 쪽 LED가 1초 간격으로 천천히 깜빡인다 (신호 대기)

두 코드의 GROUP_ID와 WIFI_CHANNEL이 같은지 확인합니다. 조종기 LED가 빠르게 깜빡이면 송신은 정상입니다. 신호가 0.5초 끊기면 판은 천천히 수평으로 돌아갑니다.

조종기 시리얼에 "MPU6050을 찾지 못했습니다"

SDA 21 / SCL 22가 바뀌지 않았는지, VCC가 3V3인지 확인합니다. WHO_AM_I 값이 0x68이 아니어도(호환칩) 정상 동작합니다.

판이 끝까지 기울면 덜컥거리거나 걸린다

혼이 수평에서 많이 벗어난 채 장착됐거나 링크 관절 너트를 너무 세게 조인 경우입니다. 수평 고정 모드에서 혼이 거의 수평인지 확인하고, 15° 이상 틀어졌으면 혼을 한 칸 옮겨 끼운 뒤 중앙값을 다시 맞춥니다. 관절 너트는 살짝 풀어 줍니다.

서보 치수가 달라 브래킷에 안 들어간다

MG996R 호환품은 ±0.5 mm씩 다릅니다. tilt_maze_cad.py의 SV_L, SV_W, SV_HOLE_DX 값을 실측값으로 바꿔 브래킷만 다시 출력하세요.

## 더 해 볼 것

- 미로 모양 바꾸기: tilt_maze_cad.py의 MAZE_SEED를 바꾸고 실행하면 새 미로판이 나옵니다. 미로판만 다시 출력해 바꿔 끼우면 됩니다.
- 도착 감지: 도착 홈 아래에 적외선 센서나 홀센서(쇠구슬)를 달아 기록 시간을 OLED에 표시.
- 실물 구멍 함정: 시뮬레이터의 구멍은 화면에만 있습니다. 같은 자리에 구멍을 뚫은 미로판을 출력하고 아래에 구슬 받이 접시를 달면 실제 미로도 고전 라비린스 게임처럼 됩니다.

모든 치수는 mm. 3D 모델은 tilt_maze_cad.py(Python, manifold3d)에서 생성되며 판 ±10° 범위에서 부품 간섭이 없음을 확인했습니다.

# 기울기 미로 조종기

연결 안 됨

컴퓨터 화면의 시뮬레이터(코드 )를 이 폰 기울기로 조종합니다. 폰의 화면 회전 잠금을 켜고 시작하기를 누르세요.

▲ 화면 안쪽

—⏱ 00:00.0

도착!

기록 저장저장 안 함

시작하기

미로판 정렬 처음부터

난이도 바꾸기 일시정지

민감도1.4×
